evolutek/CarteIORaspberryPi/CarteIO V6/Output/Schematics.pdf

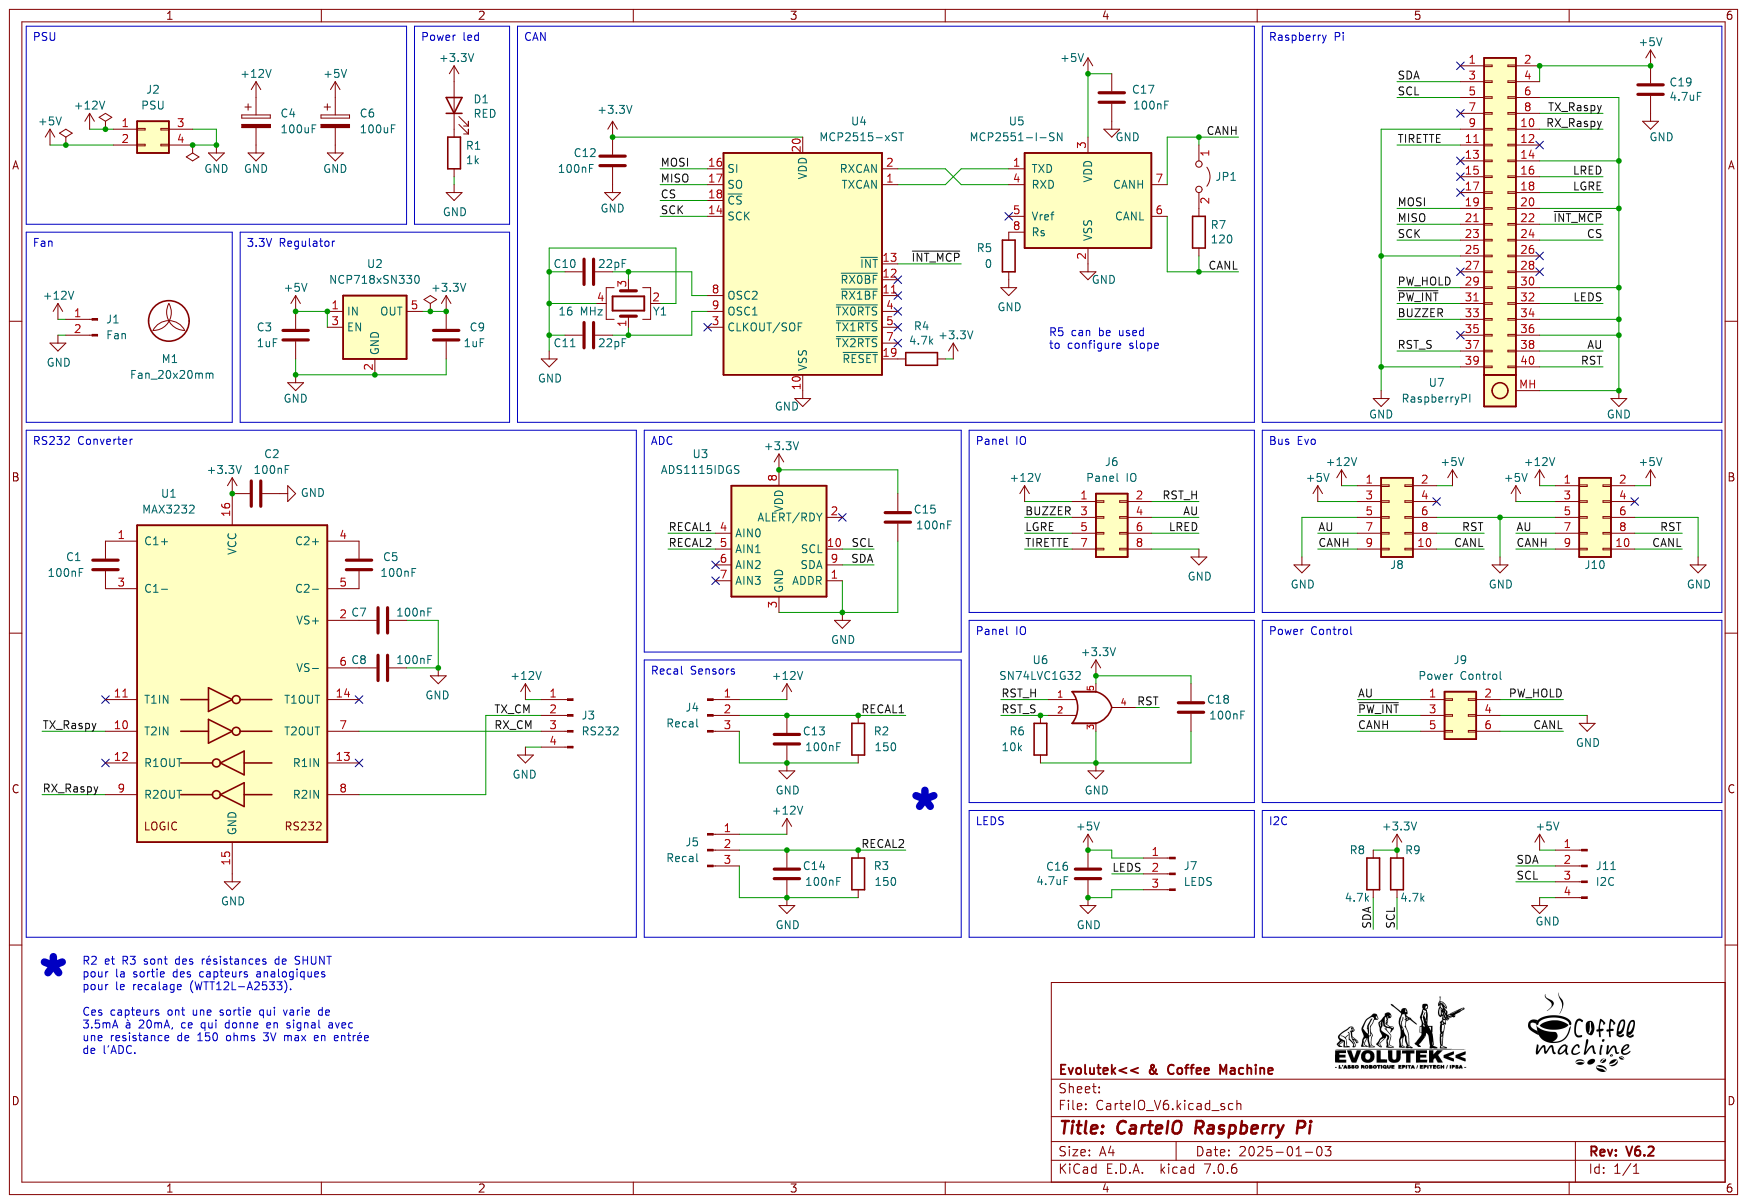
[picture p1: page 1]
