evolutek/CarteIORaspberryPi/CarteIO V6/Output/Board-Front.pdf

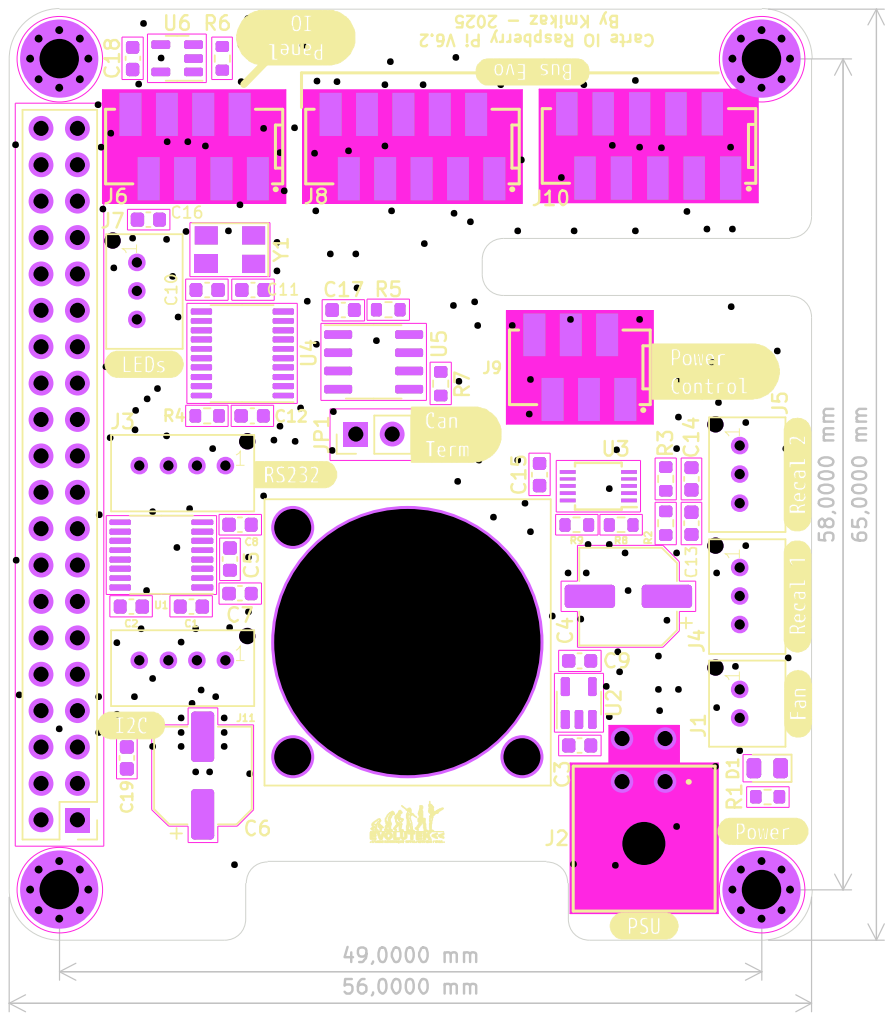
[picture p2: page 1]
